RickyAks004/Laundry-Management-Queue-Control-in-8051-Microcontroller/(list of files, drawings)

Other design files:
Washing Machine.pdsprj
